zepedroufu/projeto-gps/docs/Apresentacao_Projeto_GPS_ESP32.pptx

Monitoramento GPS
veicular com ESP32

Desafio do processo seletivo
Estágio em Hardware Embarcado

Mapa com grafico de velocidade (dados de demonstracao)

Capturas com dados de demonstração

23/10/2026

Notes: Abertura: em uma frase, o projeto monitora a posição do carro com uma ESP32 e um GPS, guarda tudo mesmo sem internet e mostra o trajeto em um mapa na web. As imagens usam dados de demonstração.

## Slide 2

O desafio e a solução

Capturar

A posição do carro com GPS, com data e hora

Princípio de projeto

Guardar e
encaminhar

O rastreamento nunca depende da internet e nenhum ponto é apagado antes de o servidor confirmar o recebimento.

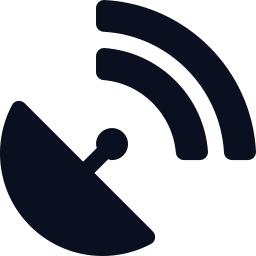
[picture p4: figure]
icone

Armazenar

Na flash da ESP32, mesmo sem internet no carro

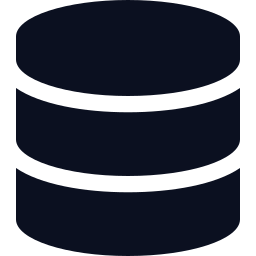
[picture p5: figure]
icone

Visualizar

Painel, mapa e tabela de viagens na web

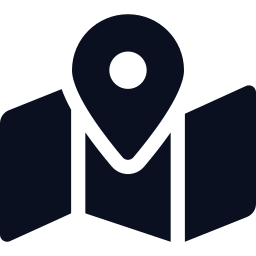
[picture p6: figure]
icone

Notes: O enunciado foi passado verbalmente, então interpretei três requisitos: capturar, armazenar e visualizar. A decisão central foi guardar e encaminhar: o carro nem sempre tem internet, então a ESP32 grava localmente e só apaga depois da confirmação do servidor.

## Slide 3

Arquitetura

GPS

NEO-M8N

ESP32

filtros + RAM

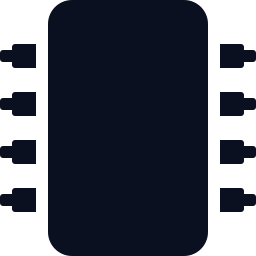
[picture p7: figure]
icone

Flash

LittleFS (CSV)

Wi-Fi

iPhone (HTTPS)

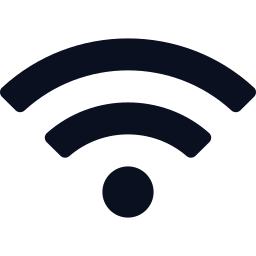
[picture p8: figure]
icone

Apps Script

+ Planilha

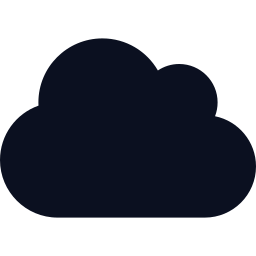
[picture p9: figure]
icone

Web

mapa e tabela

10 pontos

por lote gravado na flash

100 pontos

por arquivo CSV

OK n

só então o arquivo é apagado

Notes: Fluxo: o GPS manda frases NMEA para a ESP32; ela filtra, guarda em lotes na flash e, quando encontra o Wi-Fi do iPhone, envia por HTTPS para um Google Apps Script que escreve na planilha. A página web lê a planilha. Só depois do OK do servidor o arquivo é apagado da ESP32.

## Slide 4

Hardware

ESP32 de 30 pinos

Wi-Fi integrado, programada no Arduino IDE

Ligações

NEO-M8N | ESP32
VCC | 3V3
GND | GND
TXD | RX2 (GPIO16)
RXD | TX2 (GPIO17)
PPS | (solto)

LED azul da ESP32: pisca = buscando · fixo = gravando · 3 piscadas = enviado

GPS NEO-M8N

GPS + GLONASS, serial 9600 baud

Antena externa SMA

No painel do carro, para melhor recepção

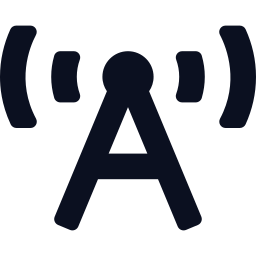
[picture p10: figure]
icone

Alimentação USB

Alimentada pelo USB (carro ou computador)

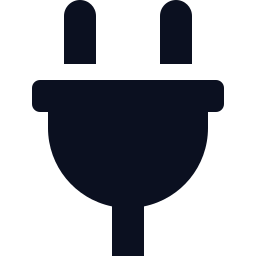
[picture p11: figure]
icone

Notes: A ESP32 conversa com o GPS pela UART2 (GPIO16 e 17). A antena externa melhora muito a recepção dentro do carro. Os LEDs ajudam a diagnosticar sem computador: o azul da ESP32 mostra o estado do firmware e o do módulo GPS pisca quando há fix.

## Slide 5

Um firmware pensado para o carro

Filtro de qualidade

Só grava com fix, ≥ 5 satélites e HDOP ≤ 3,0

Parado sem deriva

Âncora de 50 m: o carro parado não anda no mapa

Hora de Brasília

UTC do GPS convertido para UTC-3 na ESP32

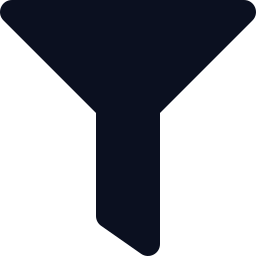
[picture p12: figure]
icone
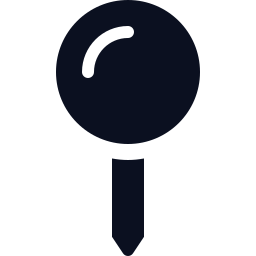
[picture p13: figure]
icone
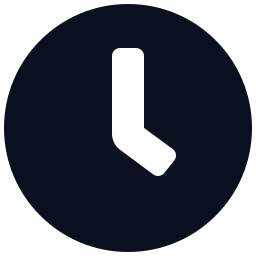
[picture p14: figure]
icone

Viagens

Cada partida é uma viagem nova (contador na NVS)

Chegada não se perde

Ao parar, grava na hora na flash

Wi-Fi sem travar

Máquina de estados; só apaga após o OK do servidor

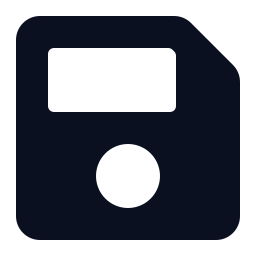
[picture p15: figure]
icone
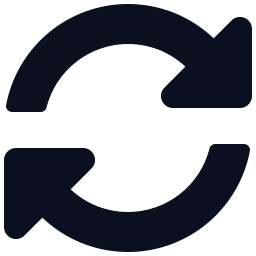
[picture p16: figure]
icone

Notes: Seis decisões que fazem diferença na prática: filtrar pontos ruins; congelar a posição quando o carro está parado; trabalhar no horário de Brasília; numerar as viagens; gravar na hora a chegada, porque ao desligar o carro a RAM se perde; e fazer o Wi-Fi sem travar a leitura do GPS.

## Slide 6

Nuvem: planilha e Apps Script

A planilha é o banco de dados

data_hora | lat | lon | vel_kmh | sat | viagem
22/10 07:40:05 | -18.9186 | -48.2772 | 21.4 | 9 | 4
22/10 07:40:10 | -18.9185 | -48.2766 | 34.8 | 10 | 4
22/10 07:40:15 | -18.9185 | -48.2759 | 42.1 | 10 | 4

Exemplo ilustrativo (dados de demonstração)

Sem servidor próprio e sem custo: o mesmo script recebe os dados e serve a página.

doPost

Recebe o CSV da ESP32 e escreve na planilha

doGet

Serve a página web, protegida por senha no link

getPontos

Entrega os pontos da planilha à página

excluirViagem

Apaga as linhas de uma viagem, conferindo cada uma

Notes: A planilha do Google funciona como banco de dados e o Apps Script como API e como servidor da página. A implantação é a mesma; para atualizar sem mudar o link usa-se Nova versão em Gerenciar implantações.

## Slide 7

Interface: painel inicial

Tela inicial da interface

Capturas com dados de demonstração

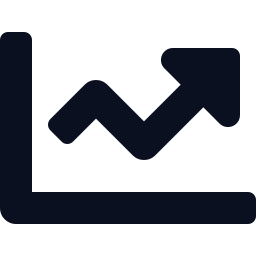
[picture p17: figure]
icone

Indicadores

Viagens, distância total, km de hoje e velocidade média

Última viagem

Saída, chegada, distância e velocidade média

Status ao vivo

Verde quando chegou posição nos últimos 15 min

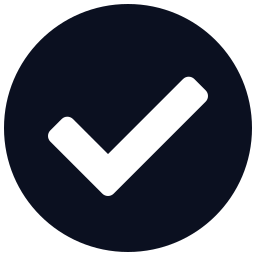
[picture p18: figure]
icone

Notes: Tela inicial em tema escuro, com atalhos para o mapa e para a tabela, indicadores gerais e o resumo da última viagem.

## Slide 8

Interface: mapa e gráfico de velocidade

Capturas com dados de demonstração; o fundo do mapa aparece com internet.

Uma cor por viagem

Saída verde, chegada vermelha

Paradas e falhas

Parada em laranja; sem sinal tracejado

Gráfico interativo

Passe o dedo e o ponto aparece no mapa

Notes: Cada viagem tem uma cor. Paradas de 2 minutos ou mais aparecem em laranja e trechos sem sinal em linha tracejada. Ao escolher uma viagem aparece o gráfico de velocidade e, ao passar o dedo nele, um ponto no mapa mostra onde o carro estava.

## Slide 9

Interface: tabela de viagens

Tabela de viagens

Capturas com dados de demonstração

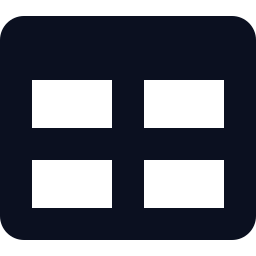
[picture p19: figure]
icone

Uma linha por viagem

Saída, chegada, duração, distância, velocidade e paradas

Ver no mapa

Abre a viagem escolhida já com o gráfico

Excluir viagem

Com confirmação; libera espaço na planilha

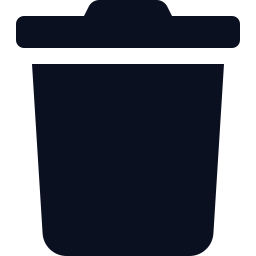
[picture p20: figure]
icone

Notes: A tabela resume cada viagem. Velocidade média é distância dividida pela duração total; a velocidade em movimento desconsidera o tempo parado. Cada linha tem Ver no mapa e Excluir.

## Slide 10

Desafios e soluções

GPS demora para o primeiro fix

Antena externa no painel e esperar o fix

Carro parado "andando" no mapa

Filtro de qualidade e âncora de posição

Horário 3 horas adiantado (UTC)

Conversão para Brasília dentro da ESP32

Última posição perdida ao desligar

Gravar na flash na hora em que o carro para

Notes: Quatro problemas reais e como foram resolvidos. O primeiro fix lento acontece porque o módulo começa a frio a cada ignição; uma bateria de backup no módulo resolve de vez e está nos próximos passos.

## Slide 11

Testes e validação

12

satélites travados com a antena externa no painel do carro

HTTP 200

envio real pelo Wi-Fi à planilha, com resposta HTTP 200

3 viagens

simuladas no PC com o código real da ESP32

3 camadas

testadas: firmware, Apps Script e interface

Notes: O que foi de fato verificado: GPS real com 12 satélites; envio real à planilha com HTTP 200; simulação do firmware no computador com viagens 1, 2 e 3; testes do Apps Script e da interface com dados simulados. Se você já fez o percurso real no carro, acrescente aqui o resultado e uma foto.

## Slide 12

Próximos passos

Bateria de backup no GPS

Partida a quente: fix em segundos

Módulo 4G

Envio em tempo real, sem o celular

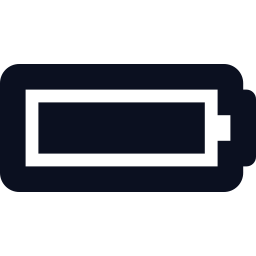
[picture p21: figure]
icone

Display OLED de status

Já projetado e testado em simulação; adiado

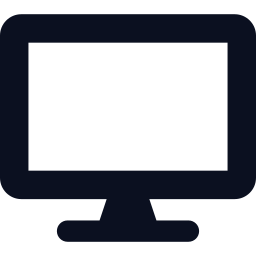
[picture p22: figure]
icone

Ventoinha com controle

MOSFET + temperatura; análise de corrente pronta

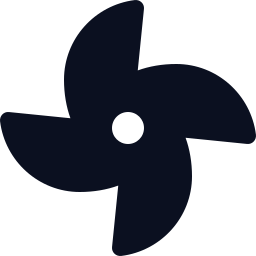
[picture p23: figure]
icone

Alerta de velocidade

Pontos acima do limite marcados no mapa

Replay da viagem

Animação do trajeto com barra de tempo

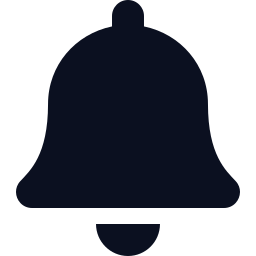
[picture p24: figure]
icone

Notes: O OLED e a ventoinha foram estudados e adiados de propósito, para não arriscar o hardware na véspera da entrega. As melhorias de maior impacto são a bateria de backup do GPS e o módulo 4G.

## Slide 13

Demonstração

Ligar a ESP32 no USB

LED azul pisca: buscando sinal

Obrigado!

Código, testes e documentação estão no repositório do GitHub.

Perguntas?

1

GPS trava

LED azul fixo: gravando o trajeto

2

Enviar para a planilha

Automático no intervalo, ou comando w

3

Abrir o mapa no celular

Viagem, paradas e gráfico de velocidade

4

Notes: Roteiro da demonstração ao vivo. Se a internet ou o GPS falharem na hora, mostre o mapa com viagens já gravadas e explique o fluxo pelo slide de arquitetura.
