zepedroufu/projeto-gps/docs/images/celular_inicio.png

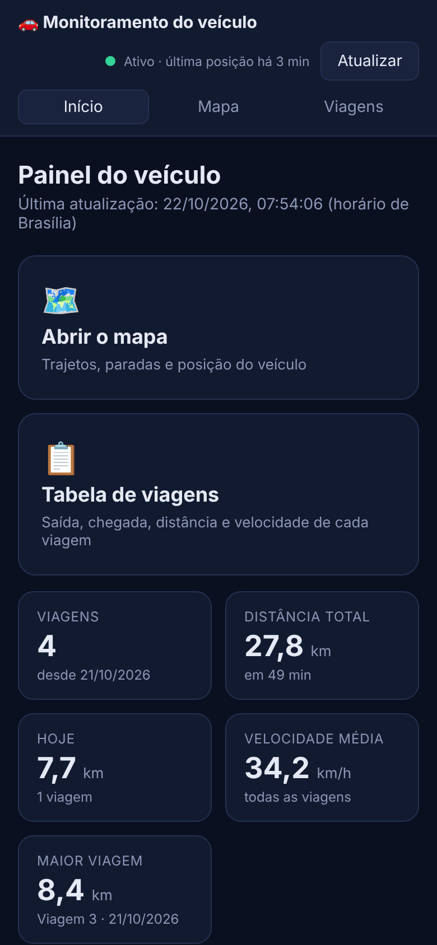
docs/images/celular_inicio.png
