zepedroufu/projeto-gps/docs/images/celular_mapa.png

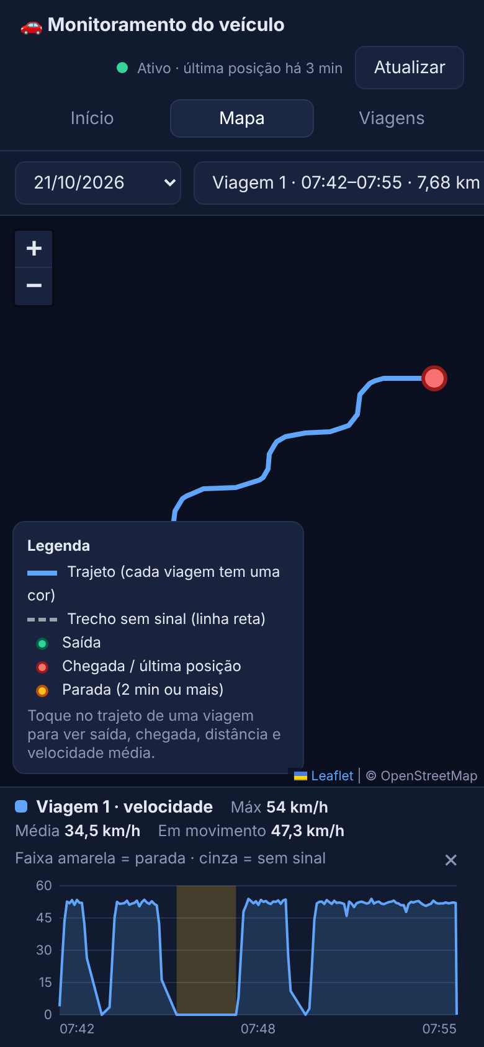
docs/images/celular_mapa.png
