zepedroufu/projeto-gps/docs/images/mapa_balao.png

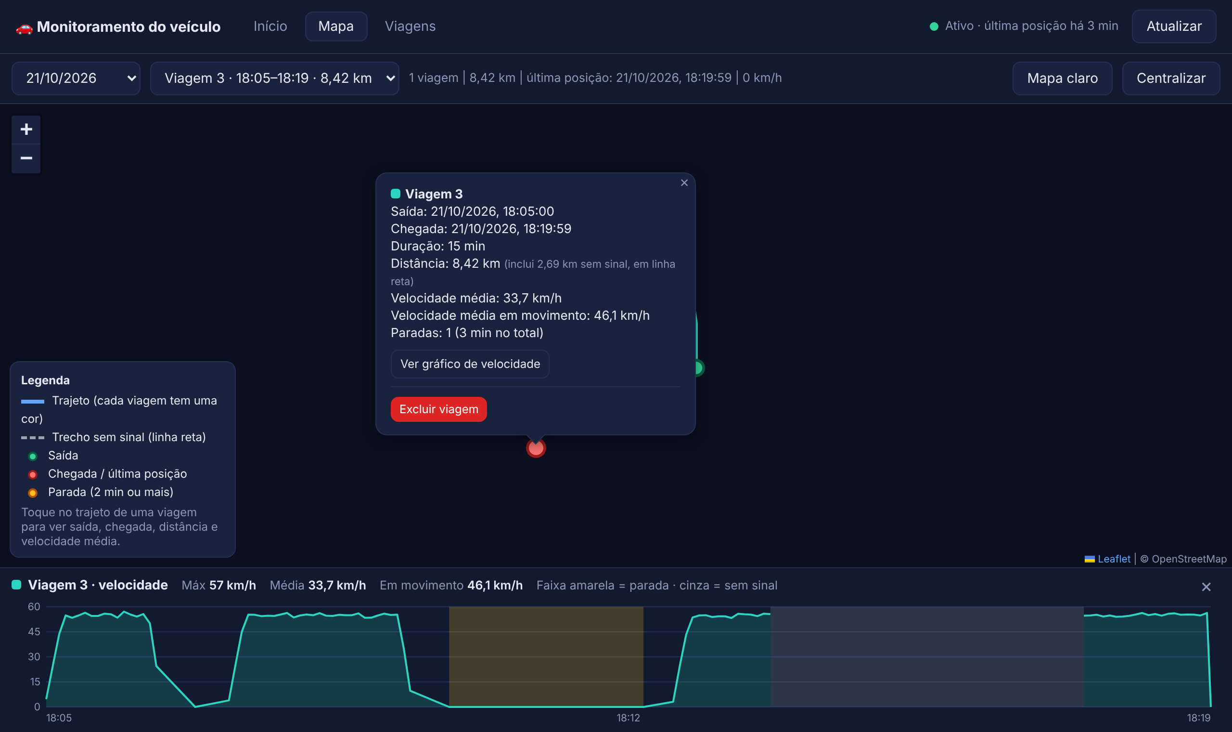
docs/images/mapa_balao.png
