zepedroufu/projeto-gps/docs/images/mapa_dia.png

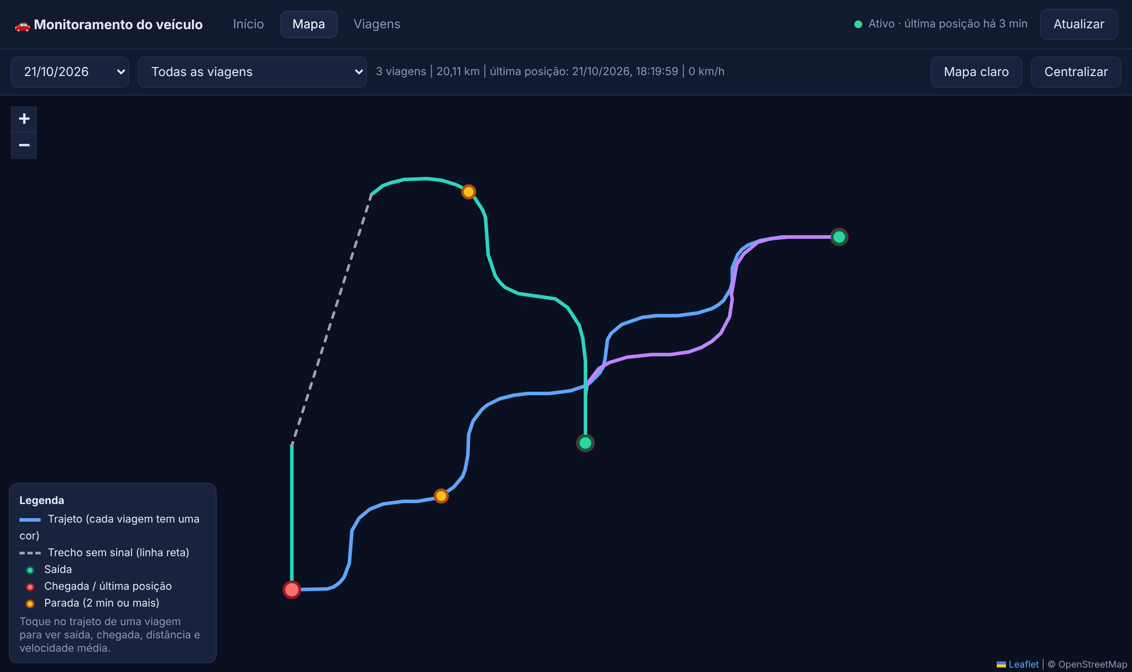
docs/images/mapa_dia.png
